JakubKolasa/PTM-Arnold/README.md

# PTM-Arnold

Celem projektu było stworzenie robota mobilnego sterowanego zdalnie.
Robot jest złożony z kilku niezależnie działających modułów. 
Ich praca jest koordynowana poprzez strukturę ,,states” dzięki której robot może wchodzić we wcześniej zaprojektowane stany.
https://www.youtube.com/watch?v=DuAApMWcmPQ
